2mikrobi/RD4-Blaupunkt2Continental/Photos/Continetal-chassis-bend.jpg

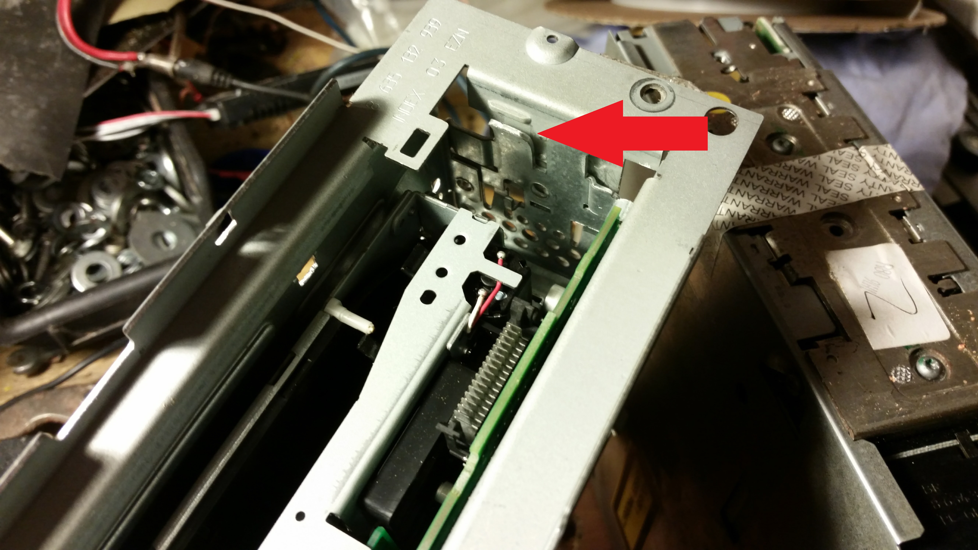
Photos/Continetal-chassis-bend.jpg
