2mikrobi/RD4-Blaupunkt2Continental/Photos/Continental-mainboard-tda3681ath-placement.jpg

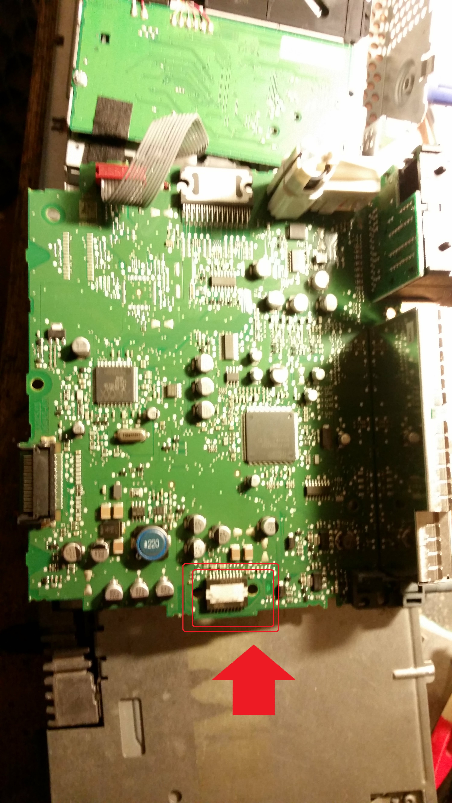
Photos/Continental-mainboard-tda3681ath-placement.jpg
