2mikrobi/RD4-Blaupunkt2Continental/README.md

RD4-Blaupunkt2Continental

Podłączenie panelu z radia RD4 Blaupunkt do radia RD4 Continental.
Daje to możliwość uruchomienia całej funkcjonalności modułu Nomade v2 - włącznie z BT Audiostreaming i USB z zachowaniem
"starego" wyglądu radia w Citroen C5 (2004-2008) i w nieznanych mi rocznikach Peugot 407.
Wykorzystuje Arduino Pro Mini 5V 16Mhz

Katalogi: 
 Kicad-schemat,
 Photos-zdjęcia
 ino - szkic Arduino
