2mikrobi/RD4-Blaupunkt2Continental/Radio RD4 - panele.pdf

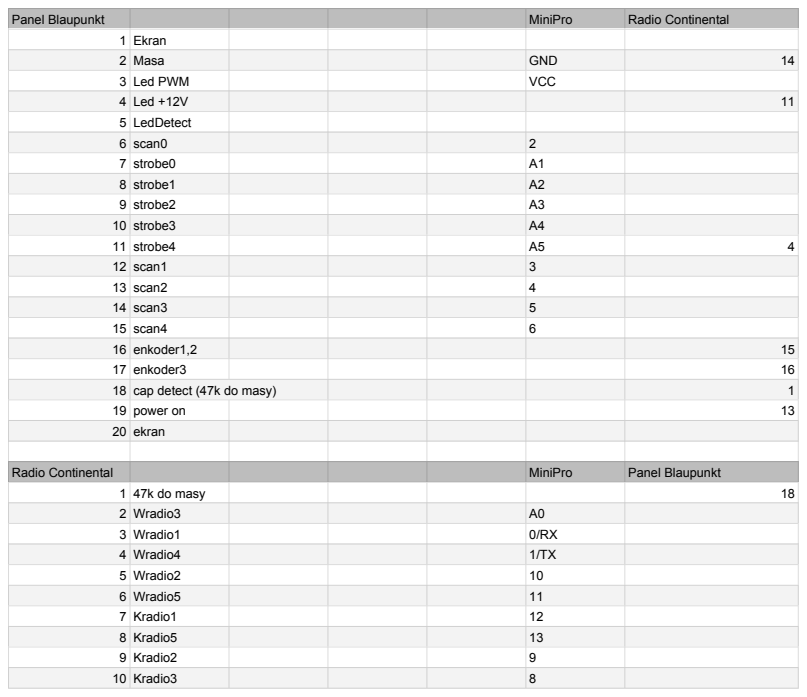
[picture p3: page 1]
Panel Blaupunkt; MiniPro; Radio Continental; 1 Ekran; 2 Masa; GND; 3 Led PWM; VCC; 4 Led +12V; 5 LedDetect; 6 scan0; 7 strobe0; 8 strobe1; 9 strobe2; 10 strobe3; 11 strobe4; 12 scan1; 13 scan2; 14 scan3; 15 scan4; 16 enkoder1,2; 17 enkoder3; 18 cap detect (47k do masy); 19 power on; 20 ekran; 1 47k do masy; 2 Wradio3; 3 Wradio1; 4 Wradio4; 5 Wradio2; 6 Wradio5; 7 Kradio1; 8 Kradio5; 9 Kradio2; 10 Kradio3

11 | Led+(zasilanie podświetlenia) | 4
12 | Kradio4 | 7
13 | PowerON | | 19
14 | Masa | | 2
15 | Enkoder1 | | 16
16 | Enkoder2 | | 17

Układ TDA 3681ATH
10 | GND(masa) | masa | | 2
19 | REG3 | +5V | Zasilanie Arduino+(RAW), otwarcie tranzystorów sterujących LED na panelu Blaupunkt | 3

| Pin
GND | 10
REG3-5V | 19
