2mikrobi/RD4-Blaupunkt2Continental/Photos/2018-05-18_10h48_48.png

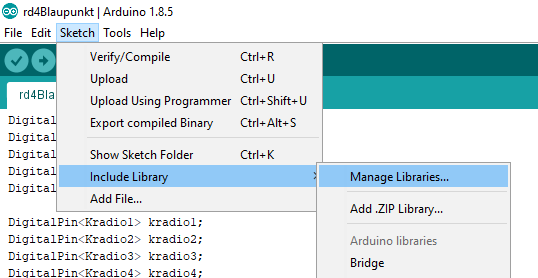
Photos/2018-05-18_10h48_48.png
