2mikrobi/RD4-Blaupunkt2Continental/Photos/Continental-tda3681ath.jpg

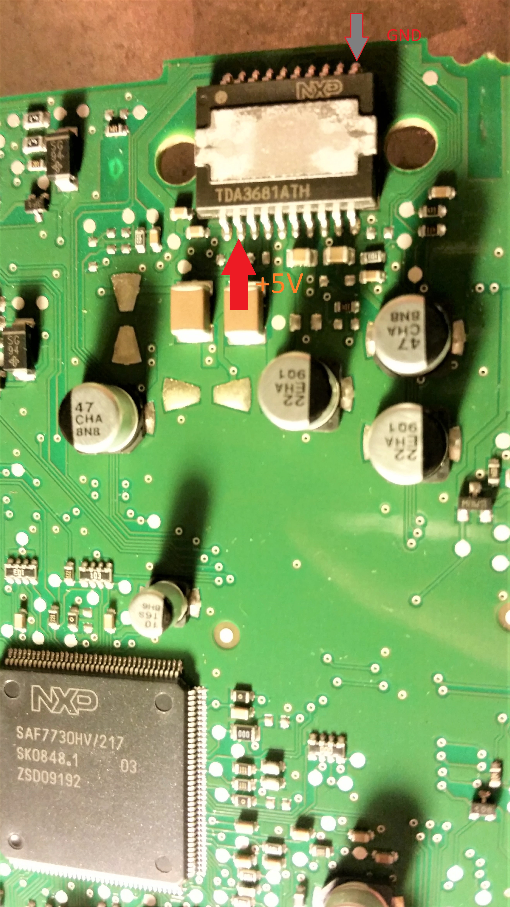
Photos/Continental-tda3681ath.jpg
