2mikrobi/RD4-Blaupunkt2Continental/Photos/Continetal-male-socket2.jpg

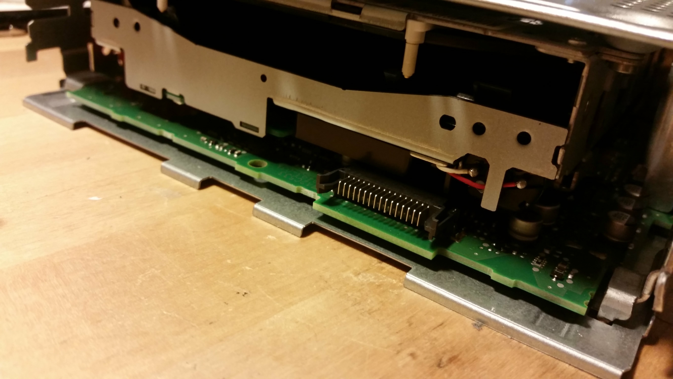
Photos/Continetal-male-socket2.jpg
