2mikrobi/RD4-Blaupunkt2Continental/Photos/Continetal-male-socket.jpg

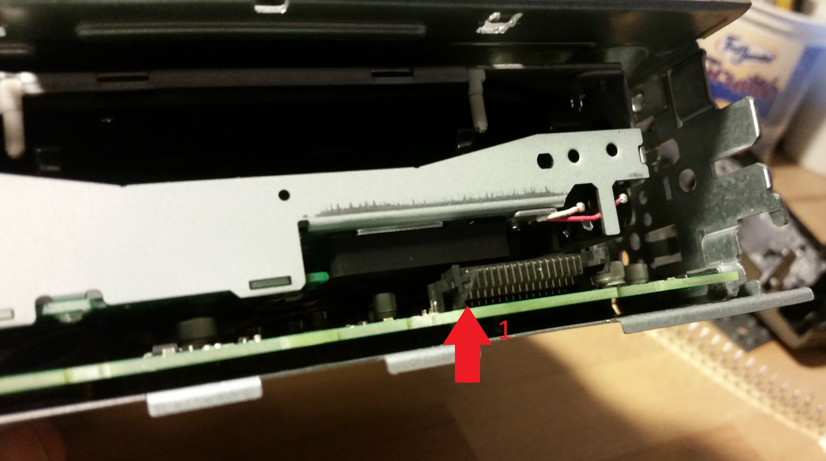
Photos/Continetal-male-socket.jpg
