2mikrobi/RD4-Blaupunkt2Continental/Photos/nomadeV2-steering-column-support.jpg

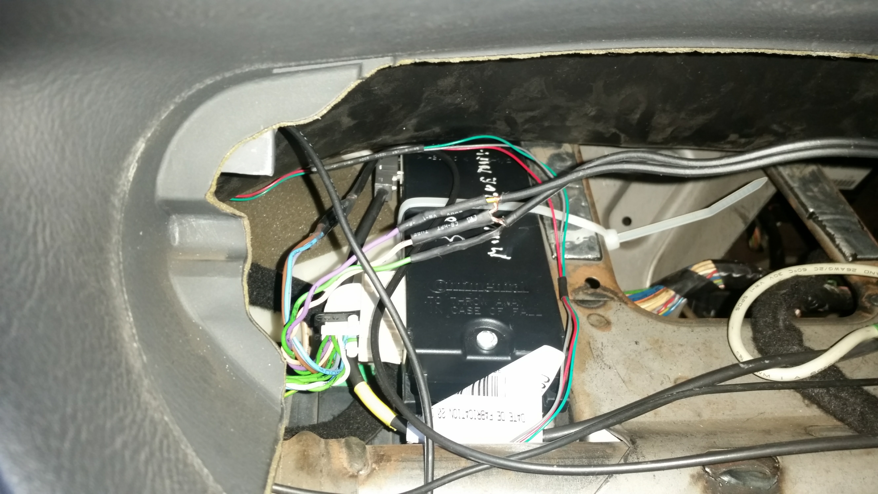
Photos/nomadeV2-steering-column-support.jpg
