2mikrobi/RD4-Blaupunkt2Continental/Photos/panel-Arduino-complete.jpg

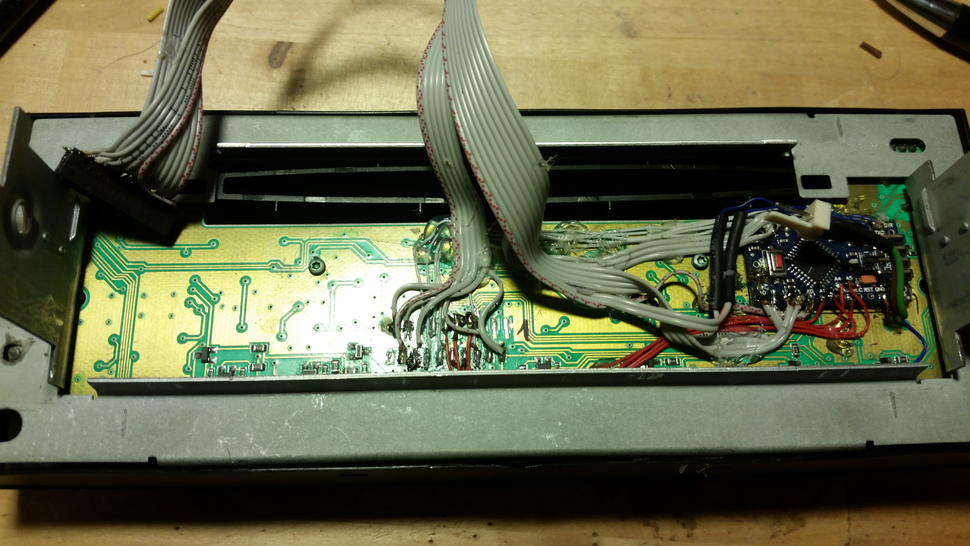
Photos/panel-Arduino-complete.jpg
