2mikrobi/RD4-Blaupunkt2Continental/Photos/panel-arduinoPro-pinsNumbers.jpg

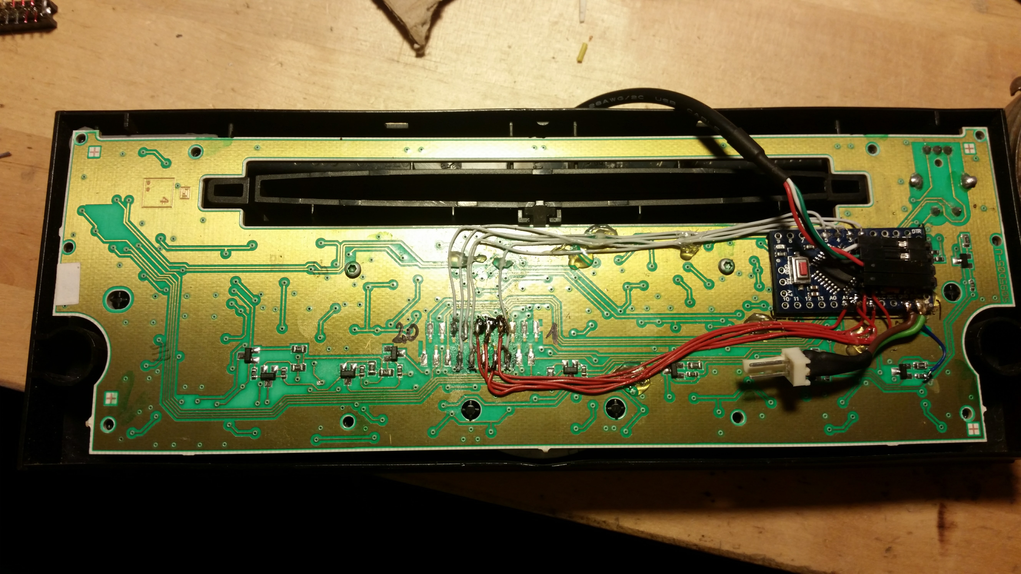
Photos/panel-arduinoPro-pinsNumbers.jpg
