2mikrobi/RD4-Blaupunkt2Continental/Photos/tda3681ath.jpg

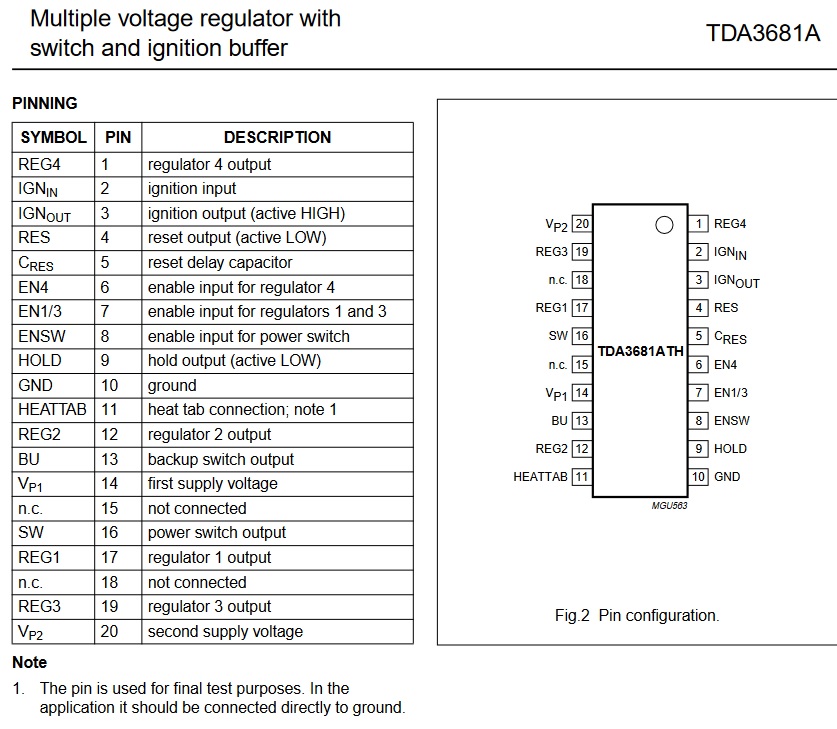
Photos/tda3681ath.jpg
